fheuer-ebv/5g-m2-usb3-interface-pcb/bom/5G - BOM board adapter.xlsx

Sheet: usb3-ngff-carrier
Reference | Quantity | Value | Footprint | MPN | Mfr
C1 | 1 | 10uF | Capacitor_SMD:C_0805_2012Metric | GRM21BR71A106KA73K | MuRata Electronics
C2 C6 C11 C16 C20 | 5 | 100nF | Capacitor_SMD:C_0603_1608Metric | C0603C104K3RAC | KEMET
C24 C25 | 2 | 0.22uF | Capacitor_SMD:C_0402_1005Metric_Pad0.74x0.62mm_HandSolder | CGA2B3X7R1E224K050BB | TDX
C3 C15 | 2 | 22uF | Capacitor_SMD:C_1210_3225Metric | CL32B226MOJNNNE | Samsung Electro-Mechanics
C4 C9 | 2 | 100uF | Capacitor_Tantalum_SMD:CP_EIA-3528-21_Kemet-B | TCJB107M006R0040 | AVX
C5 C10 | 2 | 1uF | Capacitor_SMD:C_0603_1608Metric | CGA3E1X7R1C105K080AC | TDK
C7 C12 C14 C17 C18 C19 C21 C22 C23 | 9 | 33pF | Capacitor_SMD:C_0603_1608Metric | 06035A330KAT2A | AVX
C8 C13 | 2 | 10pF | Capacitor_SMD:C_0603_1608Metric | 06035A100JAT4A | AVX
D1 D2 | 2 | MBRA340 | Diode_SMD:D_SMA | B340AE-13 | ON Semiconductor
D3 D4 | 2 | LED | LED_SMD:LED_0805_2012Metric | APTD2012LQBC/D | Kingbright
H1 H2 | 2 | M2 Threaded Insert | footprint:9774015243RStandoff | 9774020243R | Wurth
J1 | 1 | KUSBX-BS1N9-1-BL30 | footprint:Wurth-692221030100-0-0-MFG | KUSBX-BS1N9-1-BL30 | Kycon
J2 | 1 | 2199119-3 | footprint:TE_2199119-3 | 2199119-3 | TE Connectivity
J3 | 1 | Jack-DC | Connector_BarrelJack:BarrelJack_Wuerth_6941xx301002 | 694106301002 | Wurth
J6 J8 | 2 | SIM2070-6-1-30-00-A | SamacSys_Parts:SIM2070613000A_card | 640-SIM2070613000A | GCT (GLOBAL CONNECTOR TECHNOLOGY)
L1 | 1 | 2.2uH | Inductor_SMD:L_Coilcraft_XAL5030 | XAL5030-222MEC | Coilcraft
R1 R4 R9 R15 R17 | 5 | 330R | Resistor_SMD:R_0603_1608Metric | CRCW0603330RFKEAC
R2 R19 R20 | 3 | 0R | Resistor_SMD:R_0603_1608Metric | RC0603FR-070RL
R3 R13 R14 R16 R18 | 5 | 10k | Resistor_SMD:R_0603_1608Metric | CR0603-FX-1002ELF
R5 | 1 | 36k5 | Resistor_SMD:R_0603_1608Metric | CRCW060336K5FKEAC
R6 R7 R8 R10 R11 R12 | 6 | 22R | Resistor_SMD:R_0603_1608Metric | CRCW060322R0JNEAC
SW1 | 1 | KMR221GLFS | footprint:CK-KMR221GLFS-MFG | KMR221GLFS | C&K
U1 | 1 | AP62301WU7 | Package_TO_SOT_SMD:TSOT-23-6 | AP62301WU-7 | Diodes Inc.
~~J5~~ | ~~1~~ | ~~Conn_01x03_Male~~ | ~~Connector_PinHeader_2.54mm:PinHeader_1x03_P2.54mm_Vertical~~

Sheet: Sheet1
Reference | Quantity | Value | Footprint | Datasheet | Part Number | Mfr | SKU | Vendor | Note | Description | Height | Mouser Price/Stock | Manufacturer_Name | Manufacturer_Part_Number | Mouser Part Number
C1 | 1 | 10uF | Capacitor_SMD:C_0805_2012Metric |  | GRM21BR71A106KA73K | MuRata Electronics | 81-GRM21BR71A106KA73K | Mouser
C2 C6 C11 C16 C20 | 5 | 100nF | Capacitor_SMD:C_0603_1608Metric |  | C0603C104K3RAC | KEMET | 80-C0603C104K3RAC | Mouser
C3 C15 | 2 | 22uF | Capacitor_SMD:C_1210_3225Metric |  | CL32B226MOJNNNE | Samsung Electro-Mechanics | 187-CL32B226MOJNNNE | Mouser
C4 C9 | 2 | 100uF | Capacitor_Tantalum_SMD:CP_EIA-3528-21_Kemet-B |  | TCJB107M006R0040 | AVX | 581-TCJB107M006R0040 | Mouser | Tantalum
C5 C10 | 2 | 1uF | Capacitor_SMD:C_0603_1608Metric |  | CGA3E1X7R1C105K080AC | TDK | 810-CGA3E1X7R1C105K080AC | Mouser
C7 C12 C14 C17 C18 C19 C21 C22 C23 | 9 | 33pF | Capacitor_SMD:C_0603_1608Metric |  | 06035A330KAT2A | AVX | 581-06035A330KAT2A | Mouser
C8 C13 | 2 | 10pF | Capacitor_SMD:C_0603_1608Metric |  | 06035A100JAT4A | AVX | 581-06035A100JAT4A | Mouser
D1 D2 | 2 | MBRA340 | Diode_SMD:D_SMA | https://www.onsemi.com/pub/Collateral/MBRA340T3-D.PDF | B340AE-13 | ON Semiconductor | 863-MBRA340T3G | Mouser
D3 D4 | 2 | LED | LED_SMD:LED_0805_2012Metric |  | APTD2012LQBC/D | Kingbright | 604-APTD2012LQBCD | Mouser | WWAN
H1 H2 | 2 | M2 Threaded Insert | footprint:9774015243RStandoff | https://www.mouser.co.uk/datasheet/2/445/9774015243R-1728818.pdf | 9774020243R | Wurth | 710-9774015243R | Mouser
J1 | 1 | KUSBX-BS1N9-1-BL30 | footprint:Wurth-692221030100-0-0-MFG | https://4donline.ihs.com/images/VipMasterIC/IC/KYCO/KYCO-S-A0001347542/KYCO-S-A0002955208-1.pdf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 | KUSBX-BS1N9-1-BL30 | Kycon | 806-KUSBX-BS1N91BL30 | Mouser
J2 | 1 | 2199119-3 | footprint:TE_2199119-3 |  | 2199119-3 | TE Connectivity | 571-2199119-3 | Mouser | NGFF (M.2 B-Key)
J3 | 1 | Jack-DC | Connector_BarrelJack:BarrelJack_Wuerth_6941xx301002 |  | 694106301002 | Wurth | 710-694106301002 | Mouser
~~J5~~ | ~~1~~ | ~~Conn_01x03_Male~~ | ~~Connector_PinHeader_2.54mm:PinHeader_1x03_P2.54mm_Vertical~~
J6 J8 | 2 | SIM2070-6-1-30-00-A | SamacSys_Parts:SIM2070613000A_card | https://gct.co/files/drawings/sim2070.pdf | 640-SIM2070613000A | GCT (GLOBAL CONNECTOR TECHNOLOGY) | SIM2070-6-1-30-00-A |  |  | Memory Card Connectors Mini SIM Push-Pull, 6P, SMT, 3.0mm prof, No Peg, W/Normally Open Switch, T&R | 3.15 | https://www.mouser.co.uk/ProductDetail/GCT/SIM2070-6-1-30-00-A?qs=KUoIvG%2F9Ilbh4l2ytM%2Ffxg%3D%3D
L1 | 1 | 2.2uH | Inductor_SMD:L_Coilcraft_XAL5030 |  | XAL5030-222MEC | Coilcraft | 994-XAL5030-222MEC | Mouser
R1 R4 R9 | 3 | 330R | Resistor_SMD:R_0603_1608Metric |  | CRCW0603330RFKEAC
R2 | 1 | 0R | Resistor_SMD:R_0603_1608Metric |  | RC0603FR-070RL
R3 R13 R14 | 3 | 10k | Resistor_SMD:R_0603_1608Metric |  | CR0603-FX-1002ELF
R5 | 1 | 36k5 | Resistor_SMD:R_0603_1608Metric |  | CRCW060336K5FKEAC | Vishay | 71-CRCW060336K5FKEA | Mouser
R6 R7 R8 R10 R11 R12 | 6 | 22R | Resistor_SMD:R_0603_1608Metric |  | CRCW060322R0JNEAC
SW1 | 1 | KMR221GLFS | footprint:CK-KMR221GLFS-MFG | https://www.ckswitches.com/media/1479/kmr2.pdf | KMR221GLFS | C&K | 611-KMR221G-LFS | Mouser
U1 | 1 | AP62301WU7 | Package_TO_SOT_SMD:TSOT-23-6 |  | AP62301WU-7 | Diodes Inc. | 621-AP62301WU-7 | Mouser
