fheuer-ebv/5g-m2-usb3-interface-pcb/schematic/usb3-ngff-carrier.pdf

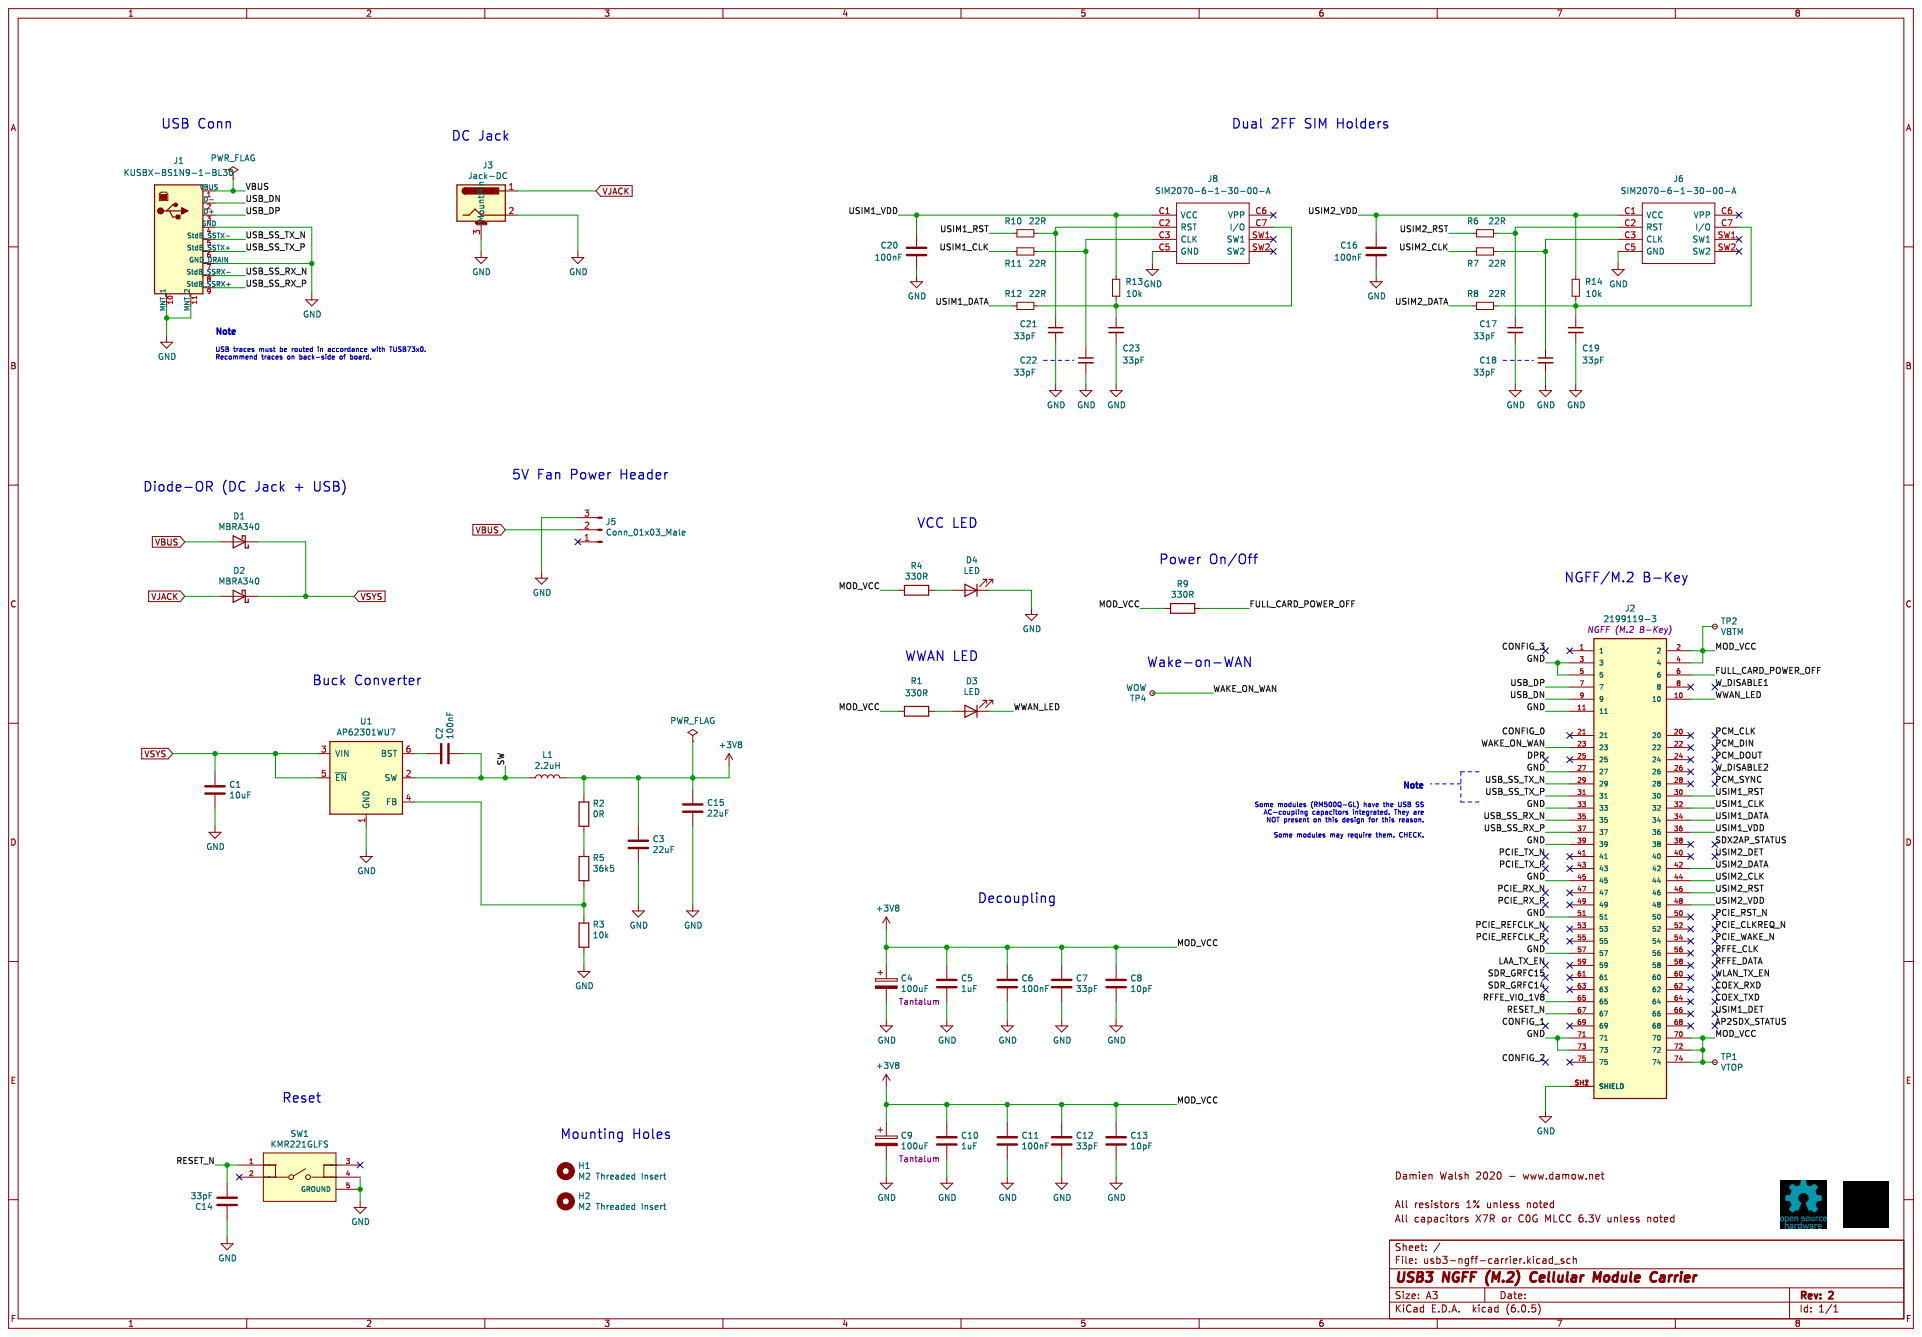
[picture p1: page 1]
