fheuer-ebv/5g-m2-usb3-interface-pcb/usb3-ngff-carrier.kicad_pcb

## KiCad design usb3-ngff-carrier.kicad_pcb (2022-06-09)

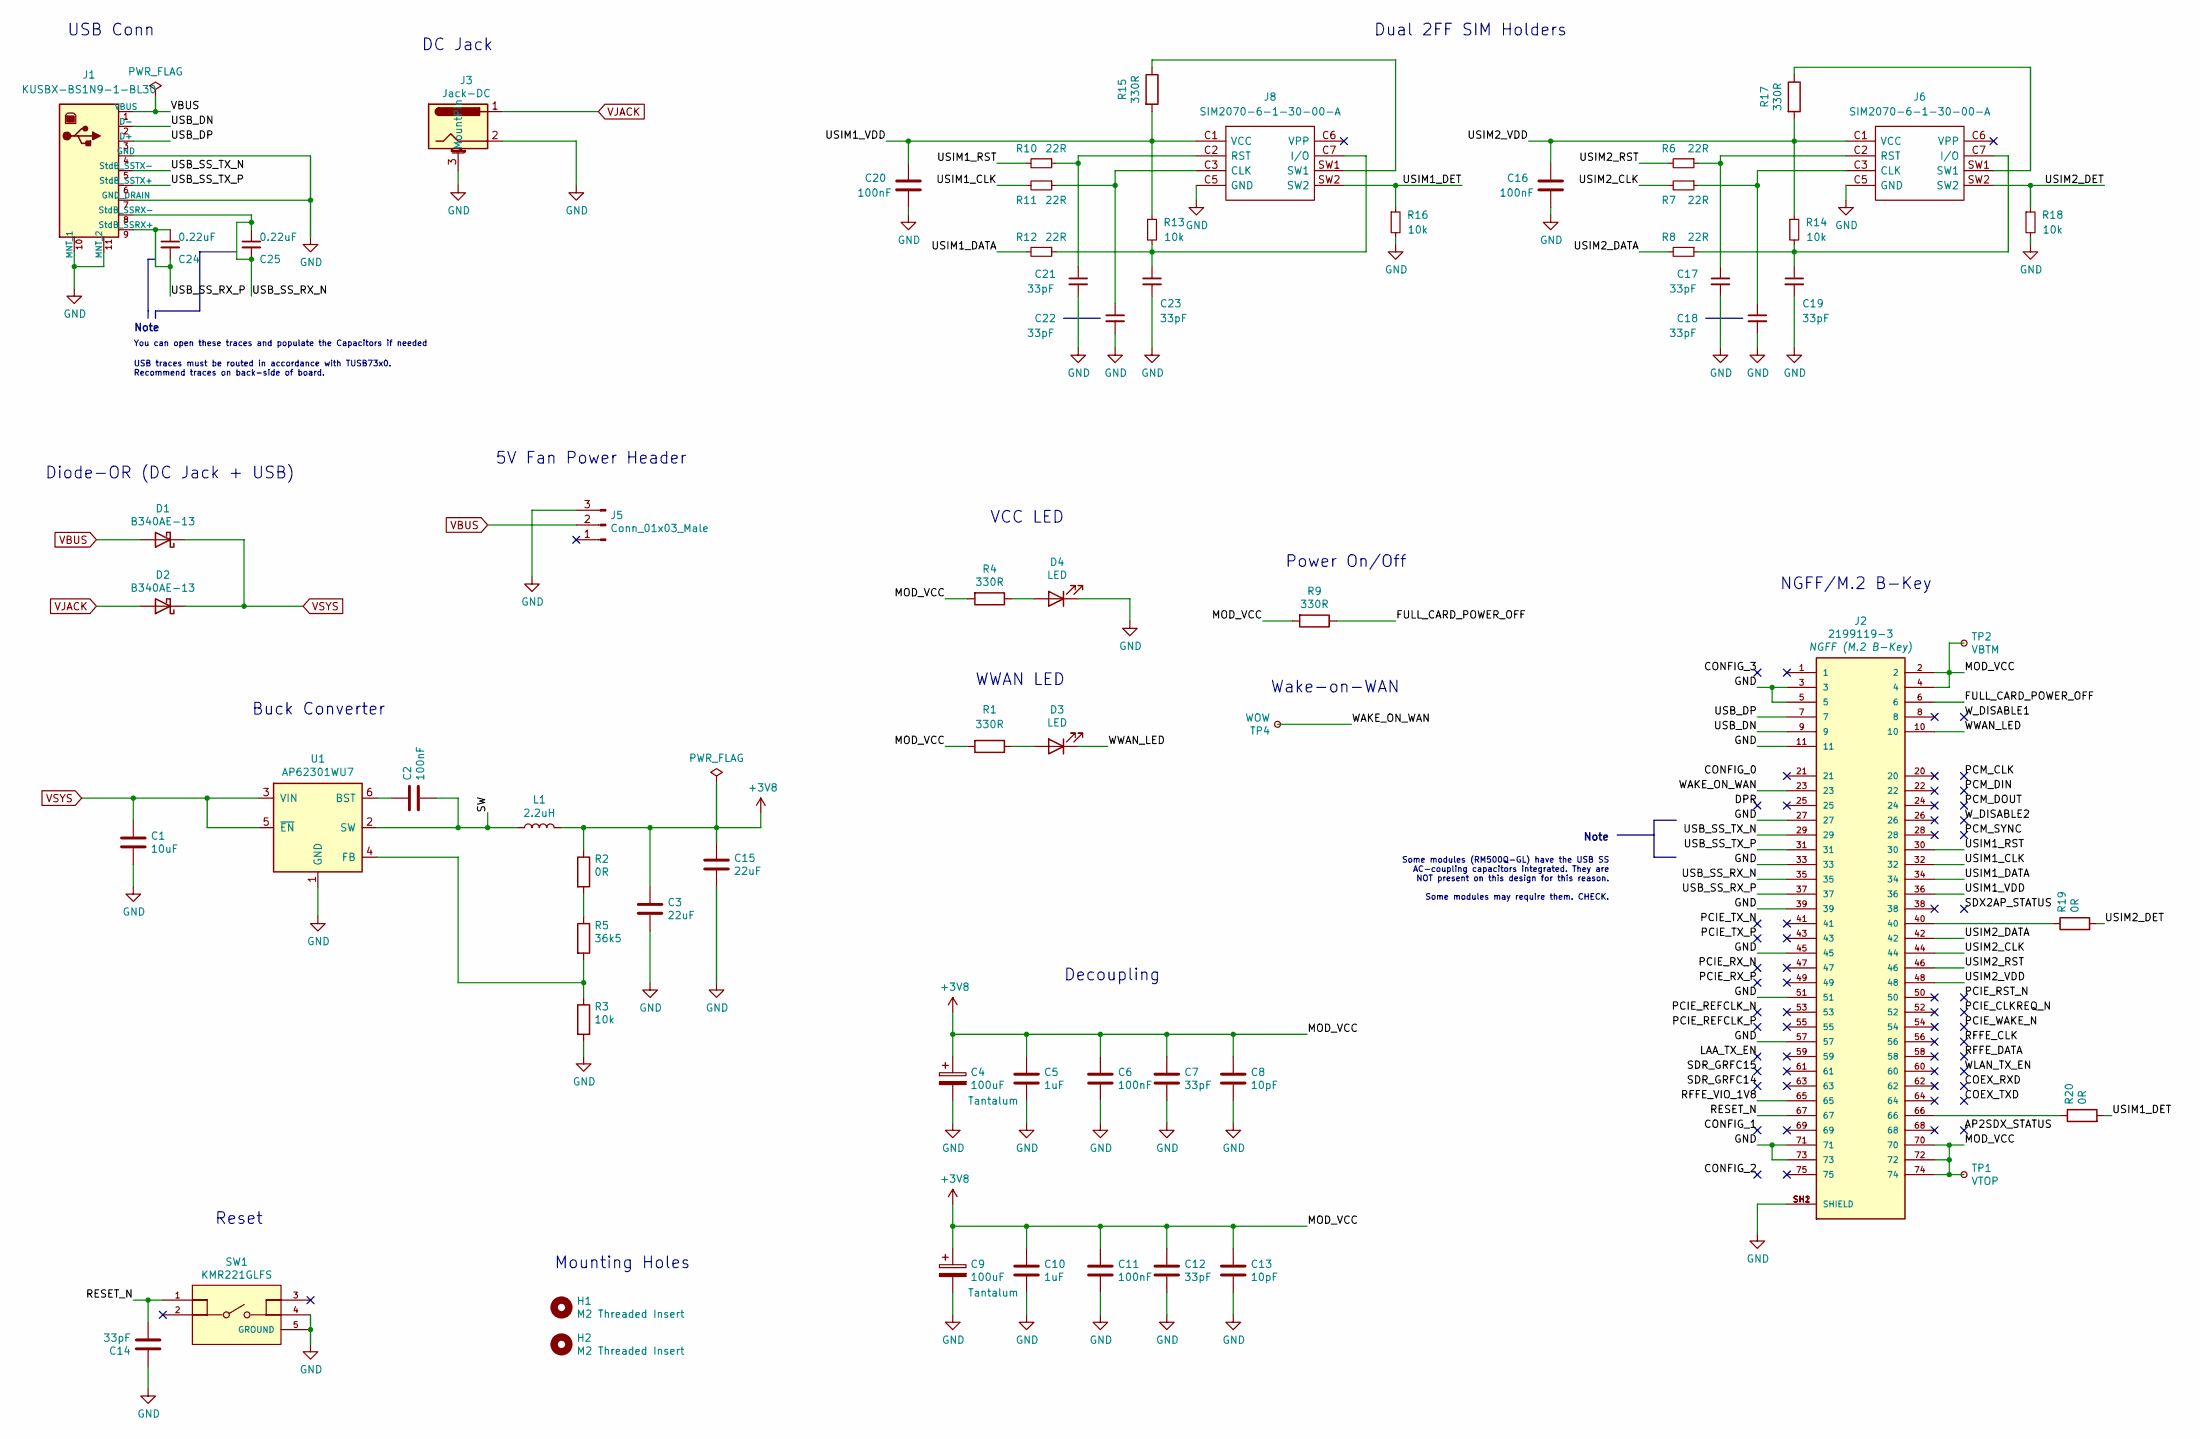
[picture p2: schematic usb3-ngff-carrier.kicad_sch, USB3 NGFF (M.2) Cellular Module Carrier]

Parts:
C1: 10uF; C_0805_2012Metric; MPN GRM21BR71A106KA73K
C2, C6, C11, C16, C20: 100nF; C_0603_1608Metric; MPN C0603C104K3RAC
C3, C15: 22uF; C_1210_3225Metric; MPN CL32B226MOJNNNE
C4, C9: 100uF; CP_EIA-3528-21_Kemet-B; MPN TCJB107M006R0040
C5, C10: 1uF; C_0603_1608Metric; MPN CGA3E1X7R1C105K080AC
C7, C12, C14, C17, C18, C19, C21, C22, C23: 33pF; C_0603_1608Metric; MPN 06035A330KAT2A
C8, C13: 10pF; C_0603_1608Metric; MPN 06035A100JAT4A
C24, C25: 0.22uF; C_0402_1005Metric_Pad0.74x0.62mm_HandSolder; MPN CGA2B3X7R1E224K050BB
D1, D2: B340AE-13; D_SMA; MPN B340AE-13
D3, D4: LED; LED_0805_2012Metric; MPN APTD2012LQBC/D
H1, H2: M2 Threaded Insert; 9774015243RStandoff; MPN 9774020243R
J1: KUSBX-BS1N9-1-BL30; Wurth-692221030100-0-0-MFG; MPN KUSBX-BS1N9-1-BL30
J2: 2199119-3; TE_2199119-3; MPN 2199119-3
J3: Jack-DC; BarrelJack_Wuerth_6941xx301002; MPN 694106301002
J5: Conn_01x03_Male; PinHeader_1x03_P2.54mm_Vertical
J6: SIM2070-6-1-30-00-A; SIM2070613000A_card; MPN 640-SIM2070613000A
J8: SIM2070-6-1-30-00-A; SIM2070613000A_card; Mouser Part Number 640-SIM2070613000A
L1: 2.2uH; L_Coilcraft_XAL5030; MPN XAL5030-222MEC
R1, R4, R9, R15, R17: 330R; R_0603_1608Metric; MPN CRCW0603330RFKEAC
R2, R19, R20: 0R; R_0603_1608Metric; MPN RC0603FR-070RL
R3, R13, R14, R16, R18: 10k; R_0603_1608Metric; MPN CR0603-FX-1002ELF
R5: 36k5; R_0603_1608Metric; MPN CRCW060336K5FKEAC
R6, R7, R8, R10, R11: 22R; R_0603_1608Metric; MPN CRCW060322R0JNEAC
R12: 22R; R_0603_1608Metric
SW1: KMR221GLFS; CK-KMR221GLFS-MFG; MPN KMR221GLFS
TP1: VTOP; TestPoint_Pad_D1.5mm
TP2: VBTM; TestPoint_Pad_D1.5mm
TP4: WOW; TestPoint_Pad_D1.5mm
U1: AP62301WU7; TSOT-23-6; MPN AP62301WU-7

Connections:
+3V8: C3.1, C4.1, C5.1, C6.1, C7.1, C8.1, C9.1, C10.1, C11.1, C12.1, C13.1, C15.1, J2.2, J2.4, J2.70, J2.72, J2.74, L1.2, R1.2, R2.1, R4.2, R9.2, TP1.1, TP2.1
/FULL_CARD_POWER_OFF: J2.6, R9.1
/RESET_N: C14.2, J2.67, SW1.1
/RFFE_VIO_1V8: J2.65
/SW: C2.2, L1.1, U1.2 (SW)
/USB_DN: J1.2 (D-), J2.9
/USB_DP: J1.3 (D+), J2.7
/USB_SS_RX_N: C25.1, C25.2, J1.8 (StdB_SSRX-), J2.35
/USB_SS_RX_P: C24.1, C24.2, J1.9 (StdB_SSRX+), J2.37
/USB_SS_TX_N: J1.5 (StdB_SSTX-), J2.29
/USB_SS_TX_P: J1.6 (StdB_SSTX+), J2.31
/USIM1_CLK: J2.32, R11.2
/USIM1_DATA: J2.34, R12.2
/USIM1_DET: J8.SW2, R16.1, R20.2
/USIM1_RST: J2.30, R10.2
/USIM1_VDD: C20.1, J2.36, J8.C1 (VCC), R13.1, R15.2
/USIM2_CLK: J2.44, R7.2
/USIM2_DATA: J2.42, R8.2
/USIM2_DET: J6.SW2, R18.1, R19.2
/USIM2_RST: J2.46, R6.2
/USIM2_VDD: C16.1, J2.48, J6.C1 (VCC), R14.1, R17.2
/WAKE_ON_WAN: J2.23, TP4.1
/WWAN_LED: D3.1 (K), J2.10
GND: C1.2, C3.2, C4.2, C5.2, C6.2, C7.2, C8.2, C9.2, C10.2, C11.2, C12.2, C13.2, C14.1, C15.2, C16.2, C17.2, C18.2, C19.2, C20.2, C21.2, C22.2, C23.2, D4.1 (K), J1.4 (GND), J1.7 (GND_DRAIN), J1.10 (MNT_1), J1.11 (MNT_2), J2.3, J2.5, J2.11, J2.27, J2.33, J2.39, J2.45, J2.51, J2.57, J2.71, J2.73, J2.SH1 (SHIELD), J2.SH2 (SHIELD), J3.2, J3.3 (MountPin), J5.3, J6.C5 (GND), J8.C5 (GND), R3.2, R16.2, R18.2, SW1.4, SW1.5 (GROUND), U1.1 (GND)
unnamed: C2.1, U1.6 (BST)
unnamed: C17.1, J6.C2 (RST), R6.1
unnamed: C18.1, J6.C3 (CLK), R7.1
unnamed: C19.1, J6.C7 (I/O), R8.1, R14.2
unnamed: C21.1, J8.C2 (RST), R10.1
unnamed: C22.1, J8.C3 (CLK), R11.1
unnamed: C23.1, J8.C7 (I/O), R12.1, R13.2
unnamed: D3.2 (A), R1.1
unnamed: D4.2 (A), R4.1
unnamed: J2.40, R19.1
unnamed: J2.66, R20.1
unnamed: J6.SW1, R17.1
unnamed: J8.SW1, R15.1
unnamed: R2.2, R5.1
unnamed: R3.1, R5.2, U1.4 (FB)
VBUS: D1.2 (A), J1.1 (VBUS), J5.2
VJACK: D2.2 (A), J3.1
VSYS: C1.1, D1.1 (K), D2.1 (K), U1.3 (VIN), U1.5 (~EN)

Notes on the sheet:
Wake-on-WAN
USB Conn
5V Fan Power Header
VCC LED
USB traces must be routed in accordance with TUSB73x0. Recommend traces on back-side of board.
Buck Converter
You can open these traces and populate the Capacitors if needed
Note
Some modules (RM500Q-GL) have the USB SS AC-coupling capacitors integrated. They are NOT present on this design for this reason. Some modules may require them. CHECK.
Power On/Off
Decoupling
WWAN LED
Diode-OR (DC Jack + USB)
Mounting Holes
NGFF/M.2 B-Key
Reset
DC Jack
Dual 2FF SIM Holders

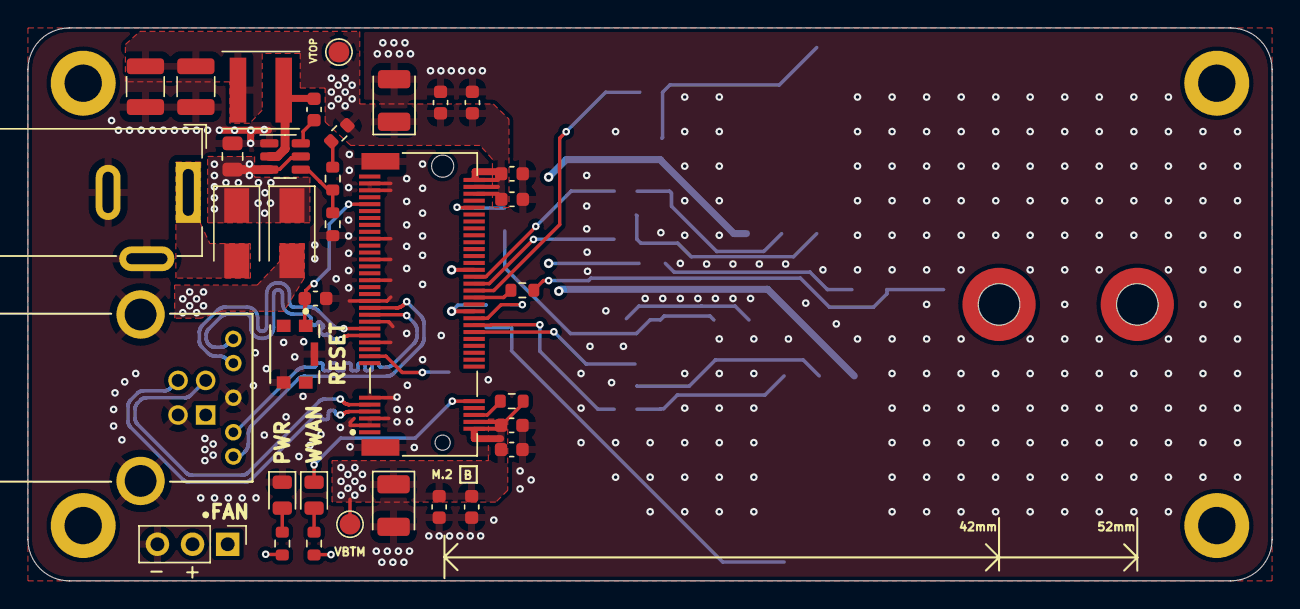
[picture p3: board usb3-ngff-carrier.kicad_pcb from above]

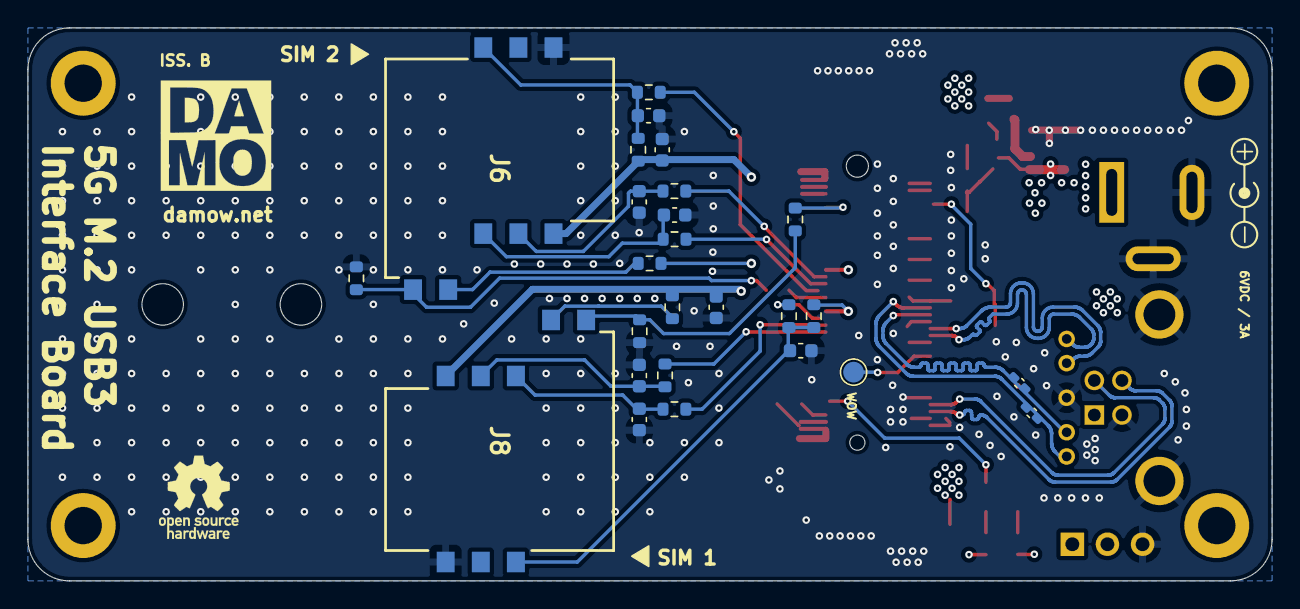
[picture p4: board usb3-ngff-carrier.kicad_pcb from below]

Board: 4 copper layers, 90.0 x 40.0 mm, 63 parts (26 on the bottom side), 41 nets.
