fheuer-ebv/5g-m2-usb3-interface-pcb/(commit log)

2022-06-07 feat: changes sim card holder to 2FF and adds missing PN to resistors
    [5G - BOM board adapter.xlsx, usb3-ngff-carrier.kicad_pcb, usb3-ngff-carrier.kicad_sch]
2022-06-08 feat: uses sim card detect pin
    [usb3-ngff-carrier.kicad_pcb, usb3-ngff-carrier.kicad_sch]
2022-06-08 feat: properly adds sim card detection
    [usb3-ngff-carrier.kicad_sch]
2022-06-08 feat: adds USB 2 capacitors pads for eventual assembly
    [usb3-ngff-carrier.kicad_pcb, usb3-ngff-carrier.kicad_sch]
2022-06-09 chore: moves M2 lenght silkscreen to the front
    [usb3-ngff-carrier.kicad_pcb]
2022-06-09 fix: reduces optional USB Caps pads to 0402 and exposes a piece of their track
    [5G - BOM board adapter.xlsx, usb3-ngff-carrier.kicad_pcb, usb3-ngff-carrier.kicad_sch, usb3-ngff-carrier_bom_1.csv]
